ChindanaiNaKub/iot-cat-feeder/PRODUCT.md

# Product

## Register

product

## Users

เจ้าของแมวหนึ่งคน ใช้มือถือเครื่องเดียวในครัวหรือหน้าตู้กับอาหาร
มืออาจเปียกหรือถือของอยู่ แมวอาจเดินมาขวางอยู่แถวเท้า
งานหลักคือเช็กว่าวันนี้ให้อาหารไปแล้วกี่ครั้ง เหลืออาหารพอไหม แล้วกดให้อาหารอีกมื้อถ้าจำเป็น

## Product Purpose

หน้าเว็บที่ NodeMCU เสิร์ฟในวง Wi-Fi บ้าน ทำหน้าที่เป็นจอควบคุมและหน้าปัดสถานะของเครื่องให้อาหารแมว
ความสำเร็จคือเจ้าของเห็นสถานะครบในสองวินาทีโดยไม่ต้องอ่านย่อหน้า และกดให้อาหารได้ด้วยนิ้วโป้งครั้งเดียว

## Brand Personality

อบอุ่น น่าไว้ใจ เงียบ
เหมือนเครื่องใช้ในบ้านที่ดี ไม่ใช่แอปที่ต้องเรียนรู้ อารมณ์คือความสบายใจว่าแมวได้กินแล้ว

## Anti-references

- หน้า admin template สีขาวเทา การ์ดเท่ากันเรียงเป็นตาราง
- ดีไซน์แบบแดชบอร์ด SaaS ที่มีกราฟเยอะจนอ่านไม่ออก
- แอนิเมชันหวือหวา และ gradient สีม่วงน้ำเงิน

## Design Principles

- สถานะมาก่อนการตกแต่ง ทุกอย่างบนจอต้องตอบคำถาม "แมวกินหรือยัง" หรือ "อาหารเหลือไหม"
- อ่านได้ในแสงกลางวันและระยะแขน ไม่ต้องเพ่ง
- ปุ่มหลักอยู่ใต้มือ ใหญ่พอสำหรับนิ้วโหว่ ๆ
- ของที่ต่อไม่ถึงต้องบอกตรง ๆ ไม่ปล่อยให้ค่าค้างดูเหมือนของจริง
- เบาพอที่จะวิ่งบน ESP8266 และเน็ตบ้าน ไม่โหลดฟอนต์จากอินเทอร์เน็ต

## Accessibility & Inclusion

คู่สีต้องผ่าน WCAG AA ที่ 4.5:1 สำหรับข้อความตัวเล็ก
ปุ่มสูงอย่างน้อย 48px
ทุกแอนิเมชันต้องหยุดได้ด้วย `prefers-reduced-motion`
ข้อมูลสถานะเป็น `aria-live="polite"` เพื่อให้โปรแกรมอ่านหน้าจอประกาศการเปลี่ยนแปลง
