ChindanaiNaKub/iot-cat-feeder/docs/feeder_3d_preview.png

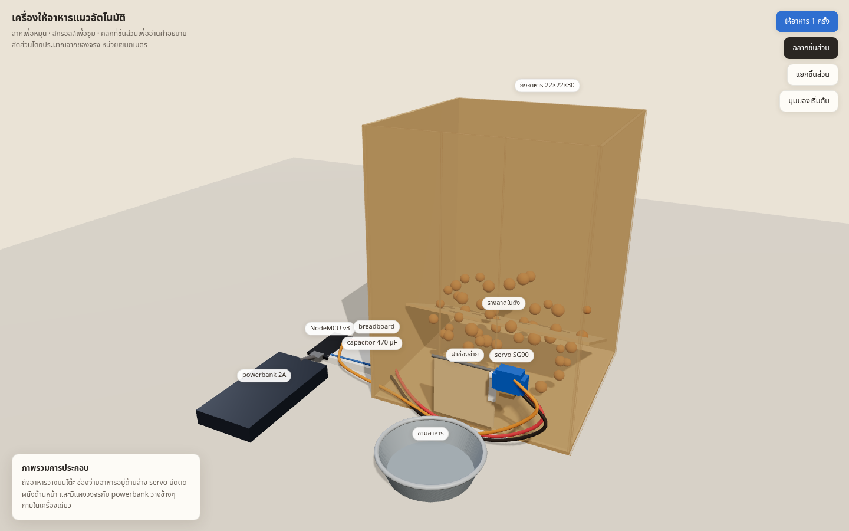
docs/feeder_3d_preview.png
