ChindanaiNaKub/iot-cat-feeder/docs/feeder_web_preview.png

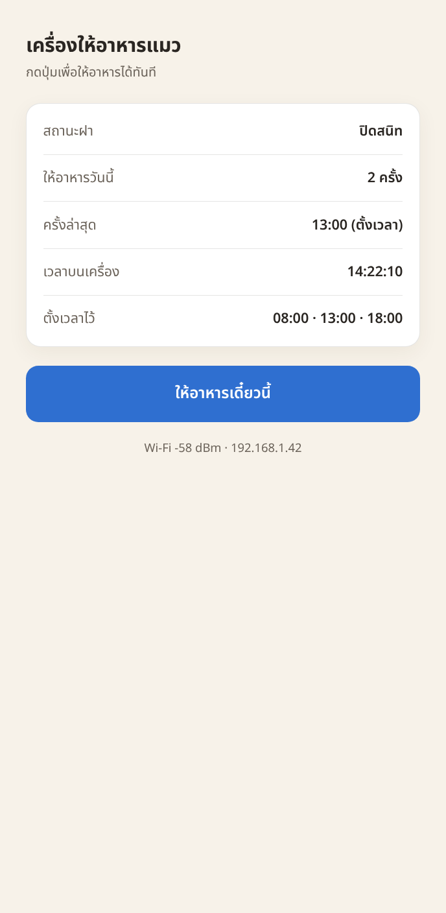
docs/feeder_web_preview.png
