ChindanaiNaKub/iot-cat-feeder/docs/wiring_full.html

# ผังการต่อระบบเต็ม: NodeMCU + Servo + HC-SR04 2 ตัว + HX711

รูปแรกคือเส้นสัญญาณ รูปที่สองคือการจ่ายไฟ ตารางด้านล่างคือสรุปทั้งหมด

## เส้นสัญญาณ

## การจ่ายไฟ

## ตารางขา

อุปกรณ์ | ขาอุปกรณ์ | ขา NodeMCU | GPIO | หมายเหตุ
Servo SG90 | สัญญาณ | D5 | 14 | PWM 50 Hz
Servo SG90 | V+ | ราง 5V | - | ห้ามต่อ 3V3
Servo SG90 | GND | ราง GND | - | กราวด์ร่วม
HC-SR04 #1 (แมว) | VCC | ราง 5V | - | กินไฟกระชากตอนยิง
HC-SR04 #1 (แมว) | TRIG | D6 | 12 | ส่งพัลส์ 10 µs
HC-SR04 #1 (แมว) | ECHO | D7 | 13 | ผ่านตัวแบ่ง 2.2k กับ 3.3k
HC-SR04 #2 (ระดับ) | VCC | ราง 5V | - | -
HC-SR04 #2 (ระดับ) | TRIG | D1 | 5 | -
HC-SR04 #2 (ระดับ) | ECHO | D2 | 4 | ผ่านตัวแบ่ง 2.2k กับ 3.3k
HX711 | VCC | 3V3 | - | ใช้ 3.3V เท่านั้น
HX711 | DT | D0 | 16 | ขาเข้าล้วน ใช้ได้ไม่มีปัญหา
HX711 | SCK | D3 | 0 | ต้องสูงตอนบูต บอร์ดมี pull-up ให้แล้ว
HX711 | GND | ราง GND | - | กราวด์ร่วม
Load cell | E+ E- A+ A- | เข้า HX711 | - | ไม่ต่อตรงกับบอร์ด

## ตัวแบ่งแรงดันที่ขา ECHO

ECHO จ่าย 5V แต่ GPIO ของ ESP8266 รับได้ 3.3V ถ้าต่อตรงอาจพัง ต้องแบ่งแรงดันก่อน ทำสองชุดสำหรับสองตัว

## วิธีติดตั้ง load cell ให้วัดได้จริง

แท่งโลหะนี้วัดได้เพราะมันงอ ตอนมีน้ำหนักกด ต้องยึดปลายข้างหนึ่งไว้กับฐาน แล้วให้อีกปลายรับน้ำหนัก ถ้าวางของทับกลางแท่งหรือรองทั้งสองข้าง มันจะไม่งอและอ่านค่าไม่ได้

ลำดับติดตั้ง: ขันสกรูสองรูฝั่งหนึ่งลงฐานให้แน่น แล้วทำเสายึดเล็กๆ ที่ปลายอีกฝั่งขึ้นมารองจานอาหาร ให้จุดสัมผัสมีจุดเดียว อย่าให้ฐานหรือจานไปแตะช่วงกลางแท่ง

เรื่องบัดกรี โมดูล HX711 ที่ซื้อมาขาเมล็ดยังไม่ได้บัดกรี ต้องบัดกรีขา 4 ขาเข้าบอร์ดก่อน ไม่งั้นเสียบสายไม่แน่นและค่าจะแกว่ง ถ้าไม่มีหัวบัดกรีให้ยืมหรือซื้อหัวเล็กๆ ราคาไม่กี่ร้อยบาท ใช้แค่ 4 จุด

สีสาย load cell ที่พบบ่อยคือ แดง E+, ดำ E-, ขาว A-, เขียว A+ แต่บางยี่ห้อสลับกัน ถ้าอ่านค่าแล้วกดลงไปแล้วค่ายิ่งลด ให้สลับ A+ กับ A-

## ลำดับที่ควรต่อ

- 1. HC-SR04 #1 ตัวเดียว ต่อ VCC, GND, TRIG D6, ECHO D7 ผ่านตัวแบ่ง แล้วรัน firmware/ultrasonic_test/ultrasonic_test.ino เอามือกวาดหน้าดูว่าค่าเปลี่ยน
- 2. HC-SR04 #2 เพิ่ม TRIG D1, ECHO D2 พร้อมตัวแบ่งอีกชุด รันสเก็ตช์เดิมดูค่าทั้งสองตัว
- 3. HX711 กับ load cell ต่อ VCC 3V3, GND, DT D0, SCK D3 รัน firmware/scale_test/scale_test.ino แล้วคาลิเบรตตามขั้นตอนในไฟล์
- 4. รวมเข้าเครื่อง ต่อเมื่อทั้งสามตัวอ่านค่าได้ถูกแล้ว ไม่ใช่ก่อน

## ข้อควรระวัง

ห้าม ต่อ VCC ของ HX711 เข้า 5V เพราะขา DT จะจ่าย 5V เข้า GPIO และอาจพังบอร์ด

ห้าม ต่อ ECHO ของ HC-SR04 เข้า GPIO ตรงๆ ถ้าเลี้ยงเซ็นเซอร์ด้วย 5V

ห้าม ถอดหรือเสียบสาย sensors ตอนบอร์ดมีไฟ

ควร ใส่ capacitor 470 µF คร่อมราง 5V กับ GND ใกล้ servo ที่สุด

ควร ต่อ servo สุดท้าย หลังเซ็นเซอร์อ่านค่าได้หมดแล้ว

สาย load cell สี่เส้นสีไม่ตรงกันทุกยี่ห้อ ถ้ากดถ้วยแล้วค่ายิ่งลด ให้สลับ A+ กับ A-
