ChindanaiNaKub/iot-cat-feeder/docs/wiring_nodemcu_servo.html

# ผังการต่อ NodeMCU + Servo SG90 + Powerbank

ต่อ GND ร่วมกันทุกจุด · ต่อ capacitor 470 µF คร่อม VIN กับ GND ใกล้ servo

VIN มีขาเดียวบนบอร์ด: ต่อ VIN ลงราง + (แดง) ของ breadboard แล้วแตกจากรางไป servo และ capacitor · GND ลงราง − (น้ำเงิน/ดำ) ทำแบบเดียวกัน

จาก | ไป | สี/หมายเหตุ
Powerbank | NodeMCU | สาย micro USB
NodeMCU VIN | ราง + (แดง) ของ breadboard | ต่อจุดเดียว แล้วแตกจากราง
NodeMCU GND | ราง − (น้ำเงิน/ดำ) | ต่อจุดเดียว แล้วแตกจากราง
Servo VCC | ราง + (แดง) | สายแดง
Servo GND | ราง − (น้ำเงิน/ดำ) | สายดำ/น้ำตาล
NodeMCU D5 | Servo สัญญาณ | สายส้ม/เหลือง
Capacitor 470 µF | คร่อมราง + กับราง − ใกล้ servo | + ไปแดง, − ไปดำ

ข้อห้าม: อย่าต่อ servo เข้า 3V3 และอย่าต่อ Capacitor กลับขั้ว
