ChindanaiNaKub/iot-cat-feeder/docs/model/wiring.html

☰

# ไล่ต่อทีละเส้น

บอร์ดวางราบนอกเบรดบอร์ด ใช้สาย female ครอบขาแล้วลากเข้าบอร์ด

← กลับไปดูภาพรวมเครื่อง

สายทั้งหมด

อ่านเบรดบอร์ดยังไง
รูห้ารูที่เรียงขวางเป็นแถวเดียวต่อถึงกัน อย่าข้ามร่องกลาง
ร่องกลางแบ่งบอร์ดเป็นสองซีก ซีกบนกับซีกล่างไม่ต่อกัน
รางที่ขอบบอร์ดยาวตลอดแนว ใช้เป็นราง 5V กับ GND

สายที่ใช้
female-to-male ใช้จากขา NodeMCU เข้าเบรดบอร์ด
female-to-female ใช้จากขา NodeMCU ตรงไปเซ็นเซอร์เลยก็ได้

## เลือกสาย

คลิกสายในโมเดลหรือในรายการ

จำนวนสายที่ต่อแล้ว

มุมมอง

ลากหมุน · สกรอลล์ซูม · คลิกสายเพื่อดูปลายทาง
