ChindanaiNaKub/iot-cat-feeder/docs/build_template_preview.png

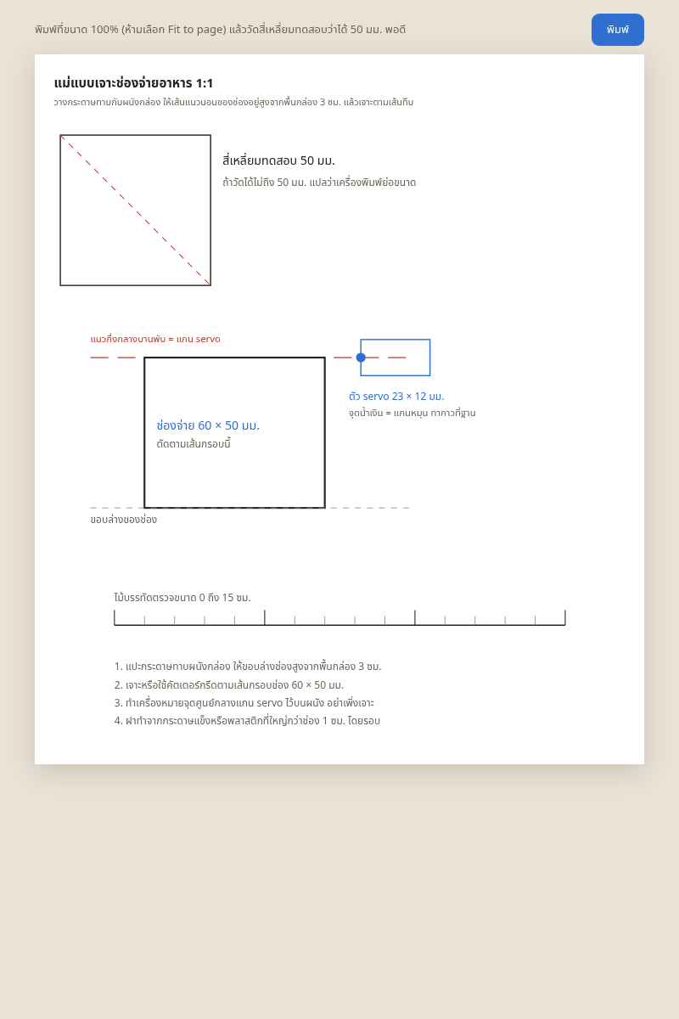
docs/build_template_preview.png
