ChindanaiNaKub/iot-cat-feeder/(commit log)

2026-10-22 Initial project docs and README
    [Project_Rubric_Idea50_Circuit30_Doc20.xlsx]
2026-10-22 Add Wokwi ESP32 servo simulation files
2026-10-22 Simplify Wokwi wire connections
2026-10-22 Fix Wokwi pin names to GPIO numbers
2026-10-30 Add proposal, SRS, and SDD documents
    Documents the cat feeder against the grading rubric. Requirements carry
    IDs so the SDD traceability table can point at code and tests.
    The SRS marks sensor requirements as pending parts, so the documents do
    not claim hardware that is not on the bench yet.
    Also ignores secrets.h so the Wi-Fi credentials stay out of the repo.
2026-10-30 Add a single bound volume alongside the three reports
    Chapter, table, figure, and appendix numbering now run continuously across
    the volume, so the printed copy reads as one report instead of three
    stapled ones. Cross-references shift with the chapter offset, and the
    rubric appendix refers to parts by name so it stays correct in both forms.
    Each report keeps its own standalone build for revision.
2026-10-31 Add interactive exploded 3D model of the feeder
    Seven assembly steps, one info card per part, and an explode slider, so the
    build order can be checked before anything is glued. Three.js is vendored
    so the page works without internet when opened through a local server.
2026-10-31 Add the full wiring plan and bring-up sketches for the new sensors
    Pin map avoids the boot strap pins for outputs that drive the board low, and
    keeps the HX711 on 3.3 V so its data line cannot exceed the GPIO limit. The
    echo lines are divided with 1k and 2k as the sensor outputs 5 V.
    Documents now record the real pins instead of "to be assigned".
    [feeder.ino, scale_test.ino, servo_test.ino, ultrasonic_test.ino]
2026-10-31 Add a breadboard-level wiring view that matches how the board is used
    The controller sits beside the breadboard on jumper wires rather than
    straddling the channel, so the model shows female leads leaving the header
    pins. Twenty six wires are grouped into six steps, each labelled with the
    jumper type, because the two types are not interchangeable at every joint.
2026-10-31 Explain load cell mounting and the header soldering step
    A bar that is supported at both ends does not bend, so the mass never
    appears. The new diagram shows the anchored end, the single load point,
    and the free span, which is the part users get wrong.
2026-10-31 Integrate the two ultrasonic sensors into the feeder firmware
    Each sensor is sampled once per loop with a 12 ms echo timeout, so the web
    server is never blocked long enough to miss a request. Presence needs three
    consecutive readings inside 60 cm, then obeys a 30 minute cooldown and a
    daily cap. The dashboard reports hopper level and whether a cat is near.
    All four sketches compile against the ESP8266 core 3.1.2.
2026-10-31 Print a boot banner, reset reason, and a status line every two seconds
    Silent firmware cannot be diagnosed over a serial console. The banner makes
    a boot loop obvious because it repeats, and the status line stops when the
    main loop stalls.
    [feeder.ino]
2026-10-31 Sweep the servo to find its real travel and stop stalling it
    Commanding 180 when the linkage stops at about 95 makes the servo fight the
    stop for the whole open window, which is the largest current draw in the
    system and the likely cause of a brownout on a USB port. The new sketch
    walks the angle in steps so the stall point can be read off the console.
    [feeder.ino, servo_test.ino]
2026-10-31 Add a probe sketch that separates a dead sensor from a dead pin
    pulseIn returning zero, and returning the timeout, point at different
    faults. Printing the raw value and the idle pin level distinguishes a
    sensor that never fires from an echo line that is stuck.
    [ultrasonic_probe.ino]
2026-11-01 Add the evidence shot list and the measurements the report needs
    The rubric scores photos and results separately, so the shots are split
    into assembly proof and function proof, and the numbers to record are
    listed next to them to avoid writing the output chapter from memory.
2026-11-01 Add the outer enclosure to the 3D assembly model
2026-11-02 Move the load cell to future work in the proposal
    The HX711 header pins were never soldered and the deadline is two days away,
    so mass control leaves v1 scope and the Nov 2 slot moves to the 24 hour
    schedule test.
2026-11-02 Use the 2.2k and 3.3k divider on the ECHO pin
    2.2k in series with 3.3k to ground gives 3.00V from the 5V echo, inside the
    3.6V pin limit and clear of the 2.475V input threshold. These are the values
    on hand.
2026-11-02 Descope the load cell in the SRS and the SDD as well
    The proposal moved portion control to Future Work, but the SRS still
    carried F5, UC-05, FR-15, and three HX711 pins marked Wired, and the
    SDD still listed a mass controller as received. Mark the requirement
    as future work, retarget the level test in its place, and rebuild the
    volume so the PDFs match the source.
    Photos are the only evidence the rubric asks for, so the video written
    into the proposal, the SRS appendix, and the evidence list is removed.
2026-11-02 Write the output and conclusion parts of the report
    The volume stopped at the design document, so the rubric items for Output
    and Discussion and for Conclusion and Future Work had nothing to point at.
    Add Part IV and Part V, and wire both into the bound volume. The measured
    column stays blank until the test record exists; the chapter says so rather
    than inventing a number.
    The echo divider in the SRS still read 1k and 2k, which the hardware no
    longer uses.
2026-11-03 Toggle the flap in the servo test instead of sweeping
    The sweep finds the travel limits once. The toggle is for checking that the flap returns to the same closed position on every cycle.
2026-11-03 Calibrate the hopper level from the dashboard
    Capture the empty and full depth on the page and keep them in EEPROM. Report no level when the reading never moves, so a misplaced mount cannot pass as a measurement.
2026-11-03 Record the hopper level sensor failure in the report
    The sensor was fixed before its aim was checked, so the beam reads the box floor and the percentage never follows the food. Part IV and Part V now say the level is not delivered, and the span is no longer described as measured.
